dianziboluo/lcd1602-studio/README.md

# LCD1602 Studio

**English → [README.en.md](README.en.md)** · 中文版见本文件

桌面端 **1602 液晶屏工作台** —— 在电脑上模拟一块真实的 HD44780 1602 屏(5x7 点阵、蓝/绿背光、走马灯),
编辑两行内容(自由文本 + 实时变量),**所见即所得地同步到 ESP32-C3 + LCD1602 真屏**。

配套硬件:合宙 CORE ESP32-C3 + PCF8574 I2C 转接板 + LCD1602。

```
PC 端 LCD1602Studio.exe (C#/WinForms, 零安装, 系统自带 csc 编译)
   ├── 数据引擎: LibreHardwareMonitorLib (CPU/SoC/内存/占用, MPL-2.0)
   ├── 可选 HWiNFO 共享内存后端 (笔记本风扇/真实 CPU 温度等 282+ 项)
   └── USB 串口 115200 → ESP32-C3 (firmware/lcd_monitor.ino)
                              └── I2C (GPIO4=SDA, GPIO5=SCL) → PCF8574 → LCD1602
```

## 特性

- **1602 模拟器**:自绘 5x7 点阵(非普通字体),蓝/绿/灭三档背光,未点亮像素可见,超长行走马灯;
  **窗口内自适应放大**(最大 13px/点阵像素,最大化窗口约 1300px 宽),背景与字形位图缓存,**每秒刷新不闪动**
- **仅 ASCII 输入**:1602 物理上只支持 ASCII —— 输入中文等字符会**自动过滤**并弹出提示(`℃` 与 `°` 例外,走自定义字形/ROM)
- **所见即所得同步**:「同步到真屏」开关,自动找 ESP32 串口,每秒下发渲染好的两行文本
- **点阵字形编辑器**:手画 5x7 自定义字符(8 个 CGRAM 槽位),缩略图列表,**拖拽到模拟屏任意格**自动插入 `{g1}`~`{g8}` 占位符;真屏同步 CGRAM(含 ℃、★、♥ 等)
- **数据台**:搜索 + [全部|内置|HWiNFO] 分段 + **分组折叠**(常用/HWiNFO·温度/HWiNFO·风扇/HWiNFO·占用/字形),类型徽章(内/温/扇/占),右对齐实时值,可一键收起
- **命令面板**:行内「插入变量」→ ⌘K 式搜索面板,Enter 插入 / Esc 关闭
- **变量插槽**:`{cpu}` `{soc}` `{gpu}` `{ram}` `{fan}` `{temp}` + HWiNFO 任意项;数值两位数(06)防跳动;`--` 表示读不到
- **预置管理**:整套模板(两行+滚动+背光)命名保存/载入/删除
- **托盘后台**:点窗口 X 缩到右下角托盘(双击恢复/右键退出),后台继续运行与同步、真屏不断更
- **零安装**:Windows 自带 .NET Framework 编译器(csc)构建,无 SDK、无运行时安装

> 屏幕效果(真实截图):

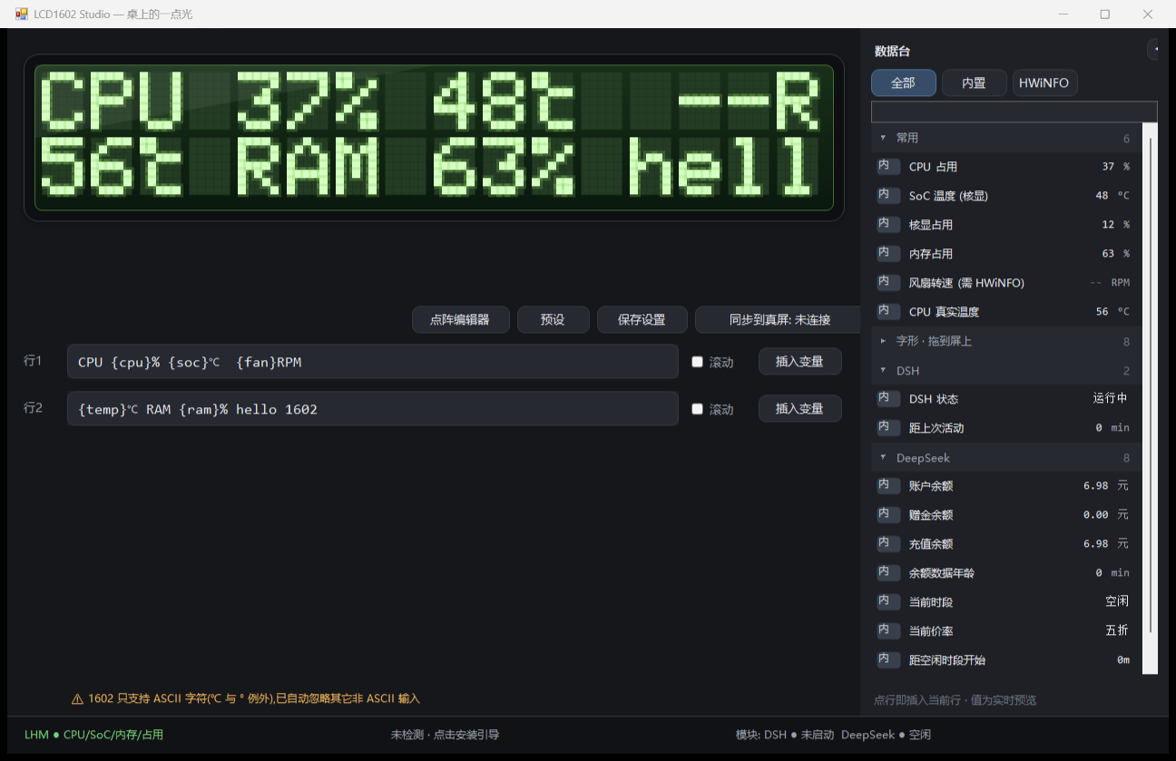
[picture p1: docs/selftest_ui.png]
sim
> 

## 快速开始(PC 端)

```
Windows 10/11
1. git clone 本仓库并进入 studio/
2. 双击 build.bat            → 首次自动下载 LibreHardwareMonitorLib(MPL-2.0)
3. 运行 LCD1602Studio.exe    → 开始编辑你的"屏幕"
```

可选数据源:状态条点「HWiNFO · 点击安装引导」,安装 HWiNFO64 并启用 Shared Memory Support
(本工具只读其公开共享内存接口,不捆绑任何 HWiNFO 组件,详见 THIRD_PARTY_LICENSES.md)。

## 硬件(本项目实测配置,详见 [HARDWARE.md](HARDWARE.md) / [HARDWARE.en.md](HARDWARE.en.md))

| 部件 | 型号 | 说明 |
|---|---|---|
| 开发板 | **合宙 CORE ESP32-C3** | ESP32-C3 单核,板载 CH343 串口,LED D4=GPIO12 |
| 显示屏 | **LCD1602A**(实测黄绿背光带背黑字款;资料另有蓝屏/3.3V 款) | HD44780 兼容,16×2,5x7 点阵,无 ℃ 字形(CGRAM 自定义) |
| 转接板 | **PCF8574 I2C 转接板**(55782 款) | 默认 0x27,板上蓝色电位器=对比度 |
| 主机 | **AMD Ryzen 7 8845HS + Radeon 780M 核显** 笔记本 | 移动 Zen4;Tctl 需 HWiNFO;本机无风扇传感器 |
| 供电 | 整机统一 **3.3V**(ESP32 GPIO 非 5V 容忍) | 勿接 5V |

> 完整实测配置/针脚/工具链版本/踩坑记录 → [HARDWARE.md](HARDWARE.md)
> (烧录时按住 BOOT、库要用 `begin()` 不用 `init()`、CGRAM 位序、℃ 之谜…… 全在里面)

### 实物照片(作者装配现场)

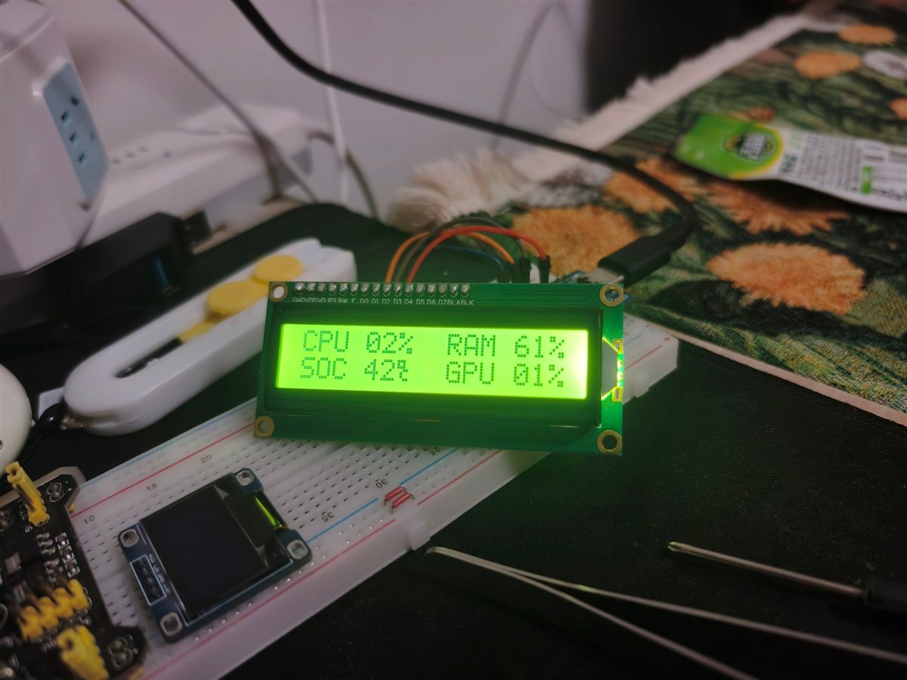
[picture p2: docs/hardware_real.jpg]
真实装配: ESP32-C3 + PCF8574 转接板 + LCD1602A(黄绿背光, 显示自定义模板)


上图:USB 供电的 ESP32-C3(左侧,自带 OLED 板未使用)经杜邦线连 PCF8574 转接板,
驱动黄绿背光 LCD1602A,屏幕正在显示用户自定义的模板: `CPU 02% RAM 61% / SOC 42° GPU 01%`
(数值两位数防跳动,° 为 ROM 度符号)。

### 接线(真屏)

**方式 A(默认,I2C 转接板,4 根线):**

| 转接板 | ESP32-C3 | 针脚 |
|---|---|---|
| VCC | 3.3V | 第 26 脚(或 18) |
| GND | GND | 第 25 脚(或 17) |
| SDA | GPIO4 (I2C_SDA) | 第 28 脚 |
| SCL | GPIO5 (I2C_SCL) | 第 27 脚 |

> 整机统一 3.3V 供电;屏亮但无字 → 调转接板蓝色电位器(对比度)。

**方式 B(不要转接板,LCD 直连开发板并行 4 位,6 根信号线):**

| LCD1602 | ESP32-C3 | 说明 |
|---|---|---|
| 1 VSS | GND | |
| 2 VDD | 3.3V | 屏是 5V 款也能用 3.3V |
| 3 V0 | 10k 电位器中间脚 | 另两脚接 3.3V / GND,调对比度 |
| 4 RS | GPIO5 | |
| 5 RW | GND | 只写,省一根线 |
| 6 E | GPIO4 | |
| 7~10 D0~D3 | 不接 | 4 位模式只用 D4~D7 |
| 11~14 D4~D7 | GPIO6 / GPIO7 / GPIO10 / GPIO3 | |
| 15 A | 3.3V 串 100~220Ω | 背光+ |
| 16 K | GND | 背光− |

> 固件里改一行 `#define LCD_DRIVER  LCD_DRIVER_PARALLEL` 即切换,**PC 端软件不用改**;
> 并行驱动自包含(`firmware/LcdParallel.h`),**不需要安装 LiquidCrystal 库**。
> 若把 LCD 的 VDD 接 5V,信号线必须加 74HCT245/TXS0108E 电平转换。
> 详见 [HARDWARE.md](HARDWARE.md) 第 6 节。

**接线图(底图直接用合宙官方 PinOut 脚位图,彩色框那 8 个脚就是要接的 8 根线):**

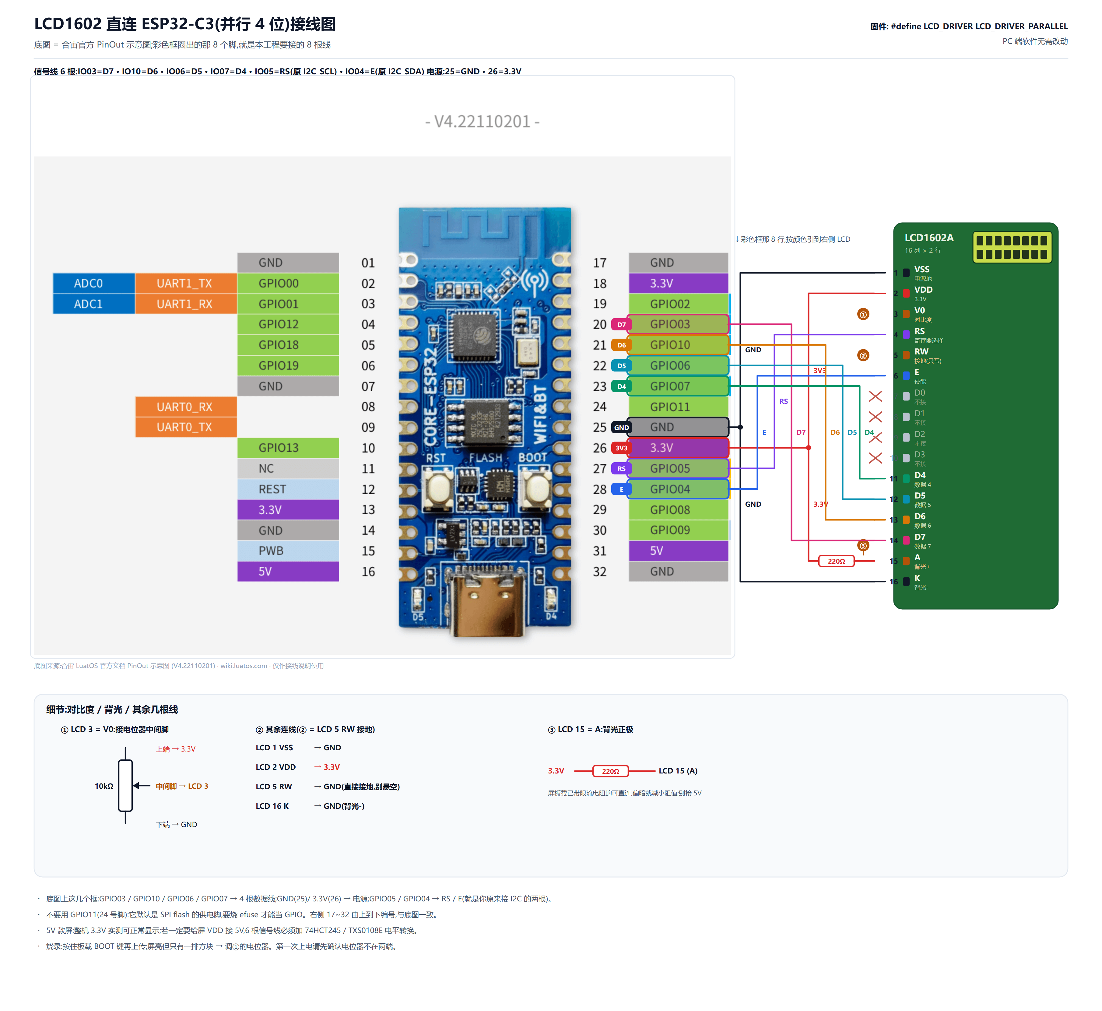
[picture p3: docs/wiring_board.png]
LCD1602 直连 ESP32-C3 接线图(官方脚位图底图)


> 另有纯矢量版 [docs/wiring.svg](docs/wiring.svg)(不含第三方图片,可自行分发/打印);
> 官方脚位图版权归合宙所有,来源已标注在图内与 [THIRD_PARTY_LICENSES.md](THIRD_PARTY_LICENSES.md)。

**面包板搭法(开发板插上沿、LCD 插下沿,同一块 170 孔面包板上)** ——
按实物插孔位置逐条标了 12 根线该插哪一列哪一排:

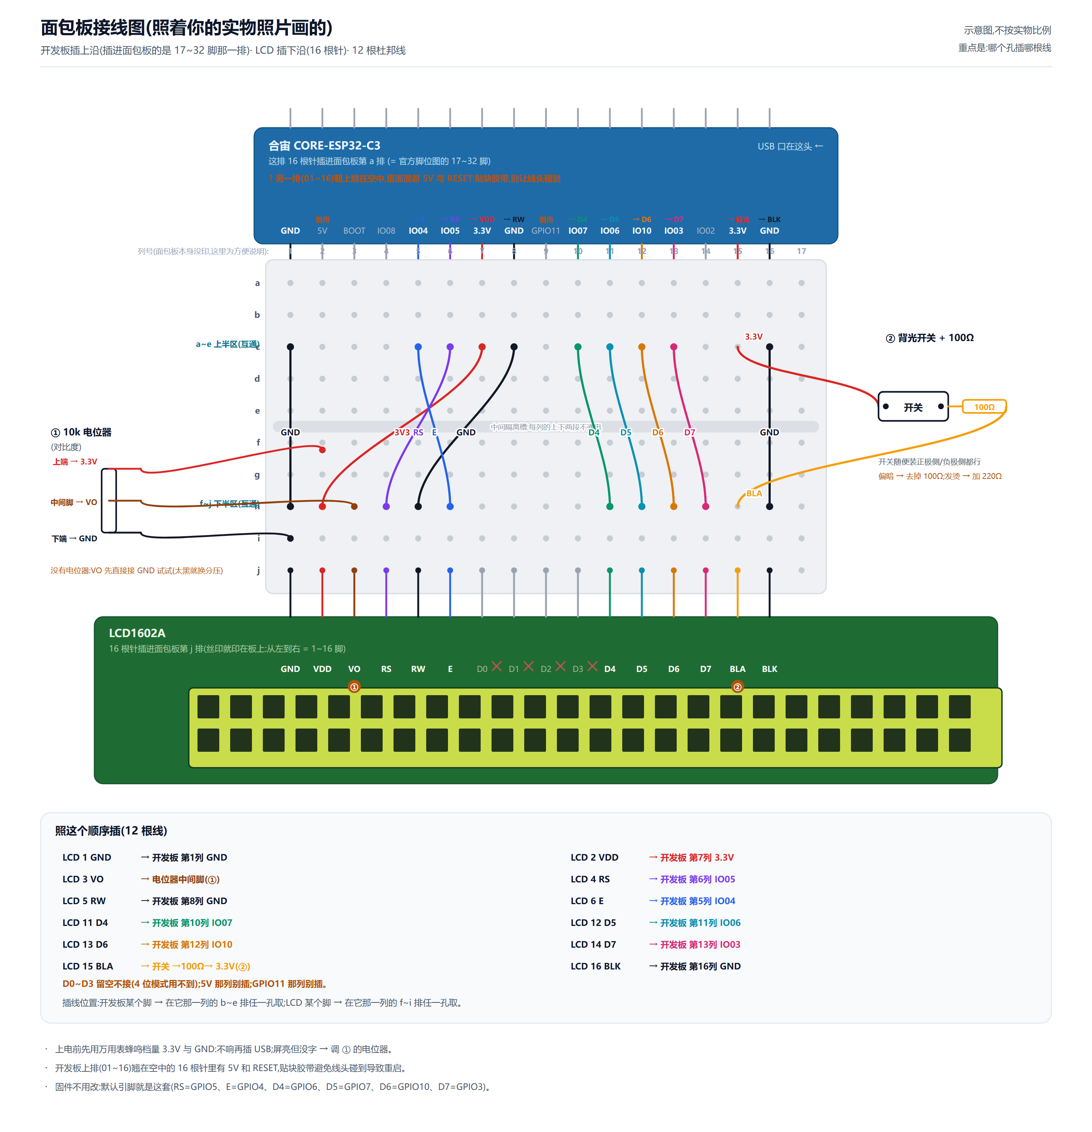
[picture p4: docs/breadboard_wiring.png]
面包板接线图


## 固件烧录(Arduino IDE)

1. `firmware/lcd_monitor.ino`;库:`LiquidCrystal_I2C`(YwRobot/PCF8574 版,仅方式 A 需要;
   方式 B 直连并行不需要任何库)
2. 工具菜单:开发板 `esp32 → AirM2M CORE ESP32C3`;**USB CDC On Boot = Enabled**
3. 上传(此板自动下载电路不可靠时:按住板载 BOOT 键再点上传)

## 扩展模块(PC 端,固件零改动)

显示器只负责显示,一切功能都在 PC 端的模块里 —— 加一个数据源 = 写一个模块 + 注册一行,
**ESP32 固件完全不用动**。详见 [MODULES.md](MODULES.md) / [MODULES.en.md](MODULES.en.md)。

| 模块 | 变量 | 说明 |
|---|---|---|
| **DSH** | `{dsh.state}` `{dsh.min}` | DSH 运行/空闲/未启动 + 距上次活动(会话文件活动 + API 连接双信号判定) |
| **DeepSeek** | `{ds.bal}` `{ds.bal.grant}` `{ds.bal.top}` `{ds.bal.age}` | 账户余额(DSH 缓存优先,过期自动调用官方 `/user/balance`) |
| | `{ds.peak.now}` `{ds.rate}` `{ds.peak.in}` `{ds.peak.left}` | 平价(空闲)时段:当前档位 / 距空闲开始 / 空闲剩余(纯本地计算) |

配置:`%APPDATA%\LCD1602Studio\modules.ini`(首次运行自动生成带注释示例)
示例模板:`CPU {cpu}% DS {ds.bal}元` / `{dsh.state} 闲 {ds.peak.in}`

> 隐私:API Key 仅本地读取(`~/.dsh/.credentials.yaml` 或手填),不写日志、不上传、不进仓库。

## 数据协议 (USB 串口 115200)

```
L0,<滚动0/1>,<文本>\n        # 行1(文本可含逗号, 16 列内显示, 滚动=走马灯)
L1,<滚动0/1>,<文本>\n        # 行2
CG,<槽0-7>,<8行字节,逗号分隔>\n  # 自定义字形(CGRAM)
兼容旧格式: C:<cpu>;S:<soc>;F:<fan>;M:<mem>\n
特殊字节: 0x01..0x08 → CGRAM 槽0..7; 0xDF = °(ROM 度符号)
```

## 目录结构

```
lcd1602-studio/
├── studio/      桌面 GUI(LCD1602Studio): 源码 + build.bat(自动下载 LHM)+ Modules/ 扩展模块
├── firmware/    ESP32-C3 固件(lcd_monitor.ino)
├── monitor/     旧版命令行主机(monitor.cs, 协议兼容, 可继续用于固定排版)
├── docs/        截图
├── LICENSE              MIT
├── README.en.md          英文文档
├── HARDWARE.md / HARDWARE.en.md  实测硬件清单(中/英)
├── MODULES.md / MODULES.en.md    扩展模块说明(中/英)
└── THIRD_PARTY_LICENSES.md
```

## 已知限制

- 笔记本模态:AMD 移动 CPU (8845HS 等) 的 Tctl 温度 LibreHardwareMonitor 读不到(开源社区已知问题),
  本工具以 SoC 核显温度代之;HWiNFO 后端可用时 `{temp}` 为真实 Tctl/Tdie。
- 此开发板/笔记本的风扇转速:LHM 与 HWiNFO 均未暴露 EC 传感器(实测 282 项读数中风扇 0 项),
  `{fan}` 显示 `--` 属硬件限制。
- 中文等非 ASCII 字符在 LCD 上显示为下划线(HD44780 物理限制);1602 屏幕 ASCII 长度 16 列/行。

## 许可证

本项目代码 **MIT**;第三方组件详见 [THIRD_PARTY_LICENSES.md](THIRD_PARTY_LICENSES.md)。
