dianziboluo/lcd1602-studio/docs/pinout_board.png

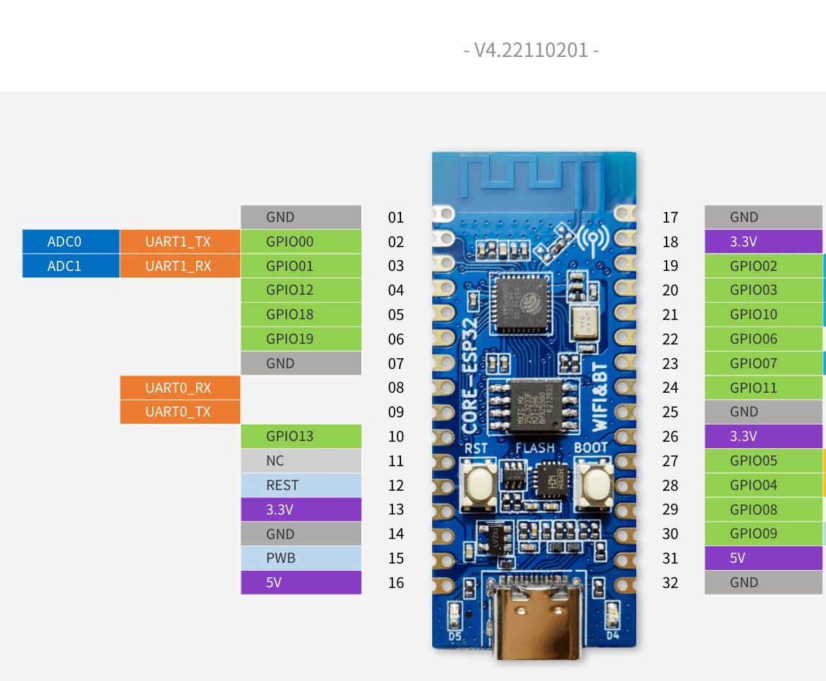
docs/pinout_board.png
