dianziboluo/lcd1602-studio/docs/selftest.png

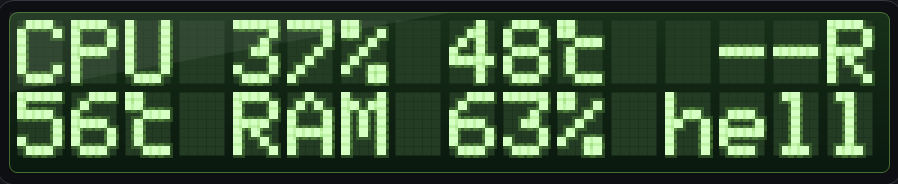
docs/selftest.png
