dianziboluo/lcd1602-studio/docs/wiring.png

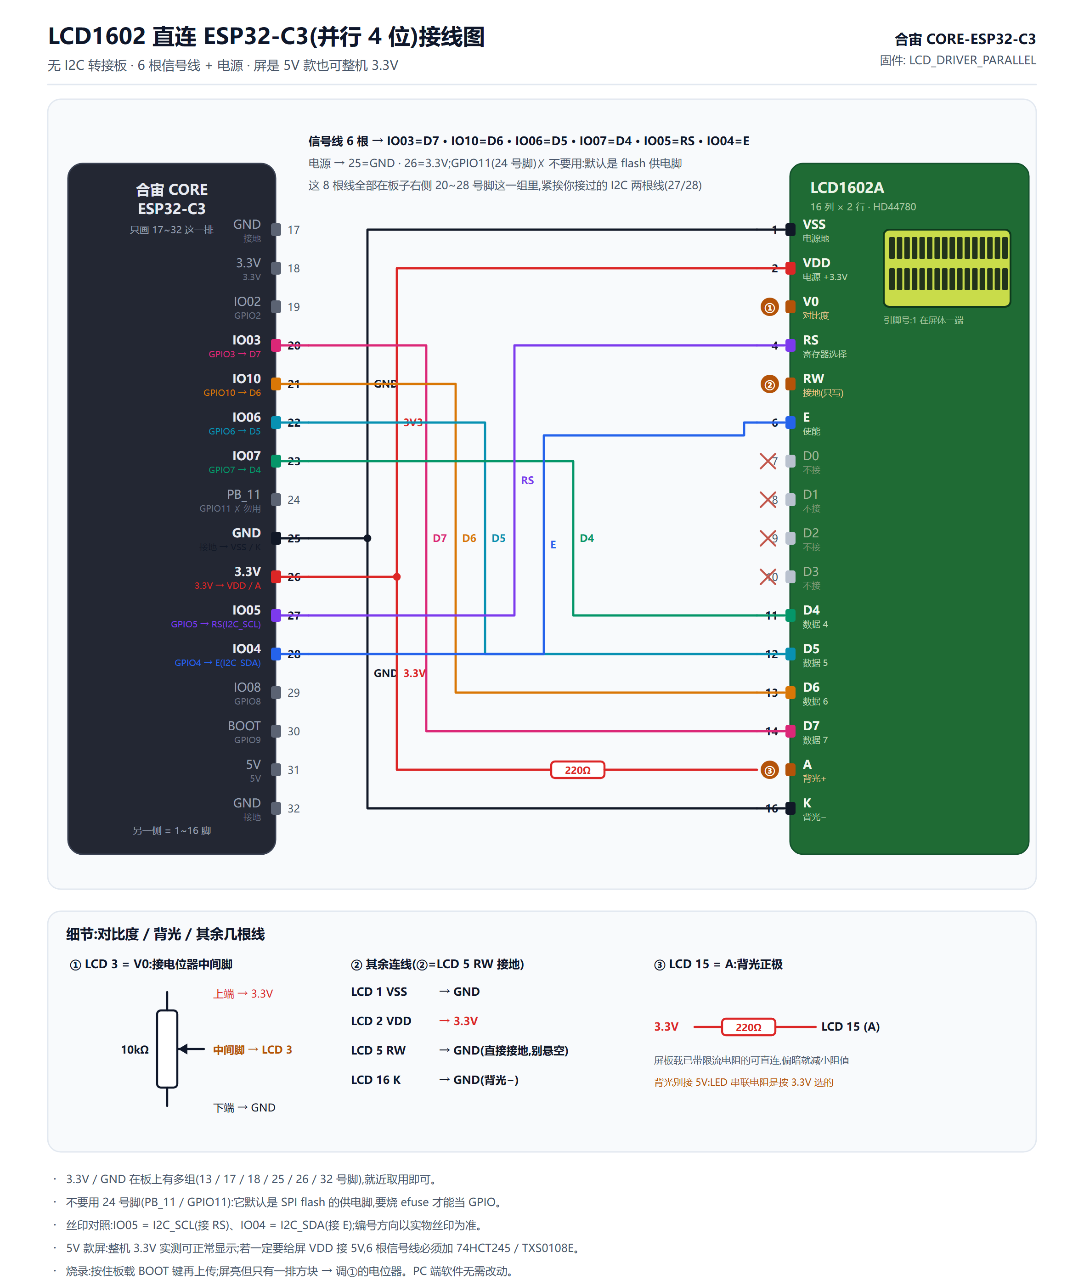
docs/wiring.png
