dianziboluo/lcd1602-studio/(commit log)

2026-08-31 LCD1602 Studio: desktop 1602 simulator + WYSIWYG sync to ESP32-C3/dot-matrix LCD (custom glyphs, presets, HWiNFO backend)
2026-08-31 docs: add HARDWARE.md (full tested hardware list, wiring, toolchain, pitfalls) and hardware section in README
2026-08-31 docs: add English docs (README.en.md, HARDWARE.en.md) + language switch link at top of README
2026-09-08 feat(modules): PC-side extension module framework + DSH status & DeepSeek balance/off-peak countdown modules; docs MODULES.md/MODULES.en.md (CN/EN); zero firmware change
2026-09-08 feat(ui): modern dark redesign - bigger LCD (920x208, scales to 13px/dot), flicker-free (cached bg/glyph bitmaps + structure-signature deck rebuild + double buffering), rounded self-drawn controls, a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
2026-09-14 feat(firmware): direct 4-bit parallel wiring (no PCF8574 adapter)
    - lcd_monitor.ino v4: LCD_DRIVER switch (I2C default / PARALLEL), PC-side untouched
    - LcdParallel.h: self-contained HD44780 4-bit driver, no LiquidCrystal library needed
    - docs: direct-wiring tables, 5V panel VIH/level-shift guidance, new pitfalls (CN/EN)
    - README: option A/B wiring, flashing note
2026-09-14 docs: add direct-wiring diagram (SVG + PNG) for parallel 4-bit hookup
    - docs/wiring.svg (vector, printable) + docs/wiring.png rendered via headless Edge
    - board pin numbers/silk names from the official CORE-ESP32-C3 pin table
    - marks GPIO11 as unusable (flash VDD_SPI pin), D0-D3 as not connected
    - embedded in README / HARDWARE (CN + EN)
2026-09-14 docs: wiring diagram now uses the official 合宙 PinOut image as base layer
    - docs/pinout_board.png: crop of the official PinOut diagram (board photo + pin numbers + silk boxes)
    - docs/wiring_board.svg|png: 8 used pins boxed in net colours, colour-routed wires into the LCD pin block
    - row coordinates machine-detected from the pin-number glyphs (pitch 33.8px), so boxes align exactly
    - THIRD_PARTY_LICENSES: attribution for the vendor image + pointer to the pure-vector fallback
    - README/HARDWARE (CN+EN) embed the board version, keep docs/wiring.svg as redistributable alternative
2026-09-18 docs: breadboard wiring diagram (jumper-per-hole, from the user's photo)
    - docs/breadboard_wiring.svg|png: dev board in row a, LCD pins in row j of a 170-point breadboard
    - every jumper drawn to its exact column/row with net colours + labels; the two external parts
    (10k contrast pot, backlight switch + 100R) shown as panels with their own wires
    - notes: 5V / GPIO11 columns must stay unused; upper half (a-e) is separate from lower half (f-j)
    - embedded in README (CN/EN) and pc_monitor/README.md
